bakathefish/LANYARD/zine.pdf

# E-I N K LANYARD

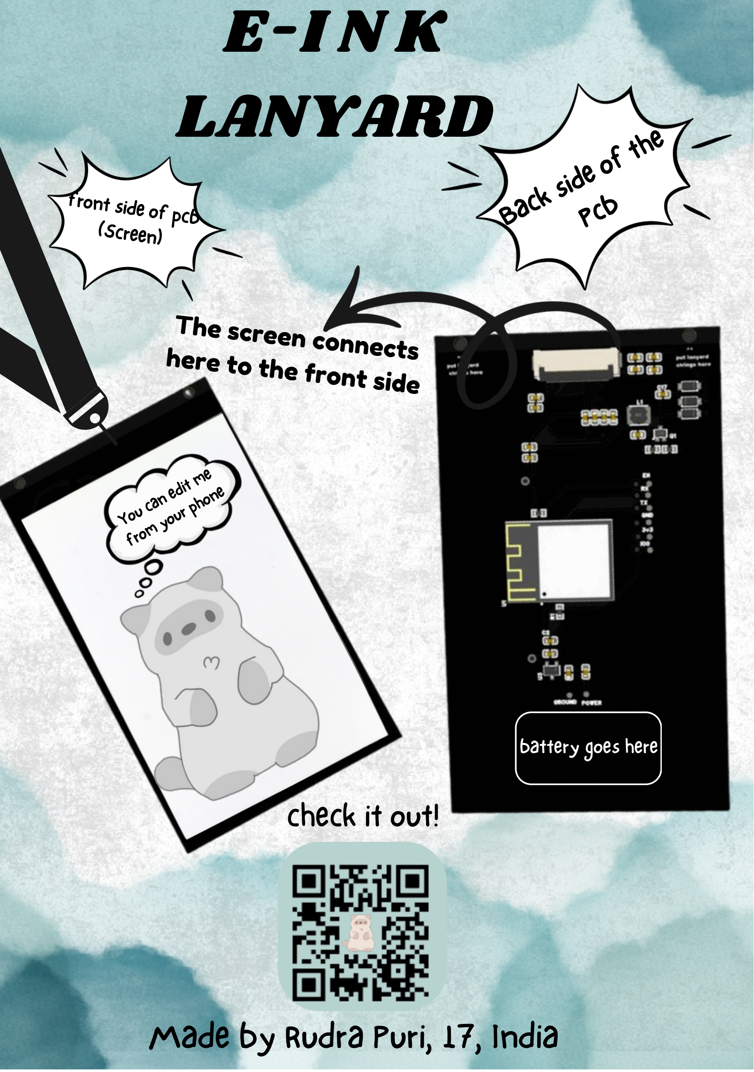
[picture p1: page 1]

You can edit me
from your phone

front side of pcb
(Screen)

# Made by Rudra Puri, 17, India

# check it out!

## Back side of the Pcb

h

The screen connects
ere to the front side

battery goes here
