bakathefish/LANYARD/(list of files, drawings)

Other design files:
PCB_FILES/Lanyard.epro
